BettinaG/Hexapod_ProjektB/README.md

# Hexapod_ProjektB

Dieses Repository enthält unser Projekt zum Bau eines sechsbeinigen Robotors (Hexapod). 
Es ist aufgeteilt in die Ordner Code, Dokumentation und ControllerApp.

**Code**

Hier sind sämtliche Dateien abgelegt, die den Code beinhalten, die den Hexapod-Roboter zum Laufen bringen. Es wird weiter unterschieden zwischen "Arduino-Files" und "Header-Files".

**ControllerApp**

Dieser Ordner enthält die fertige ControllerApp, sowie die Datei mit der die Anwendung weiter modifiziert werden kann. Dafür dann hier http://ai2.appinventor.mit.edu/ einloggen und die .aia Datei importieren.

**Dokumentation**

Die Dokumentation ist aufgeteilt in eine Projektauswertung.pdf und eine Dokumentation.pdf. Letzteres enthält eine Bedienunsanleitung, ein Entwicklerhandbuch, sowie eine Beschreibung der Softwarearchitektur.
Außerdem enthält der Ordner ein paar Bilder des von uns gebauten Hexapods.
